azizelse-0v2/complexio/Assets/QFN_24.STEP

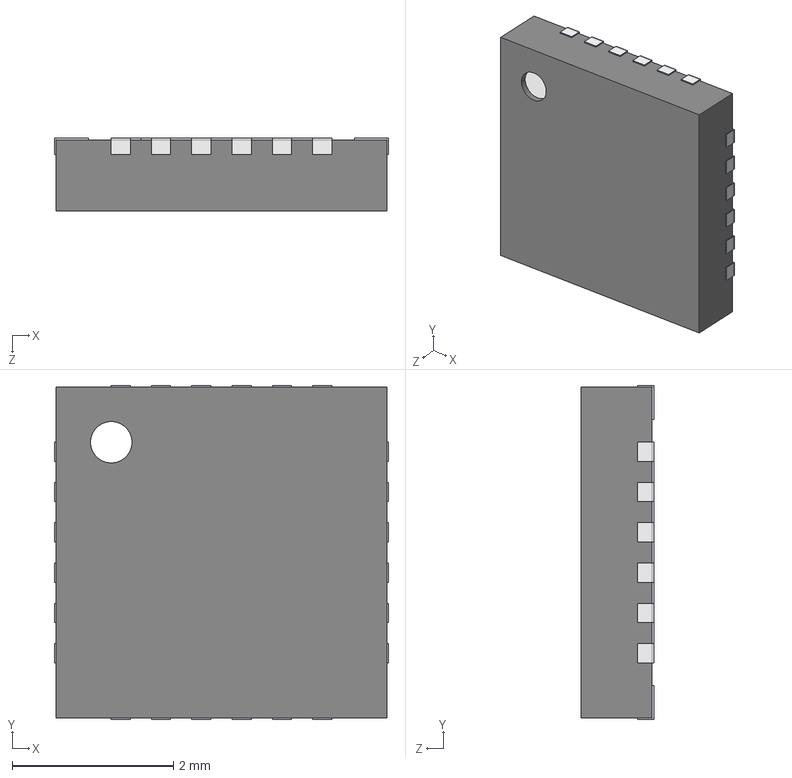
[picture p1: CAD file, 2026-03-24]
Assets/QFN_24.STEP
4.14 x 4.14 x 0.9 mm
Open_CASCADE_STEP_translator_6.8_11.2.1.step_Varsay考an
Open_CASCADE_STEP_translator_6.8_11.4.1.step_Varsay考an x 24
Open_CASCADE_STEP_translator_6.8_11.1.step_Varsay考an
Thermal_Shape.step_Varsay考an
