azizelse-0v2/complexio/Assets/hc-05.stl

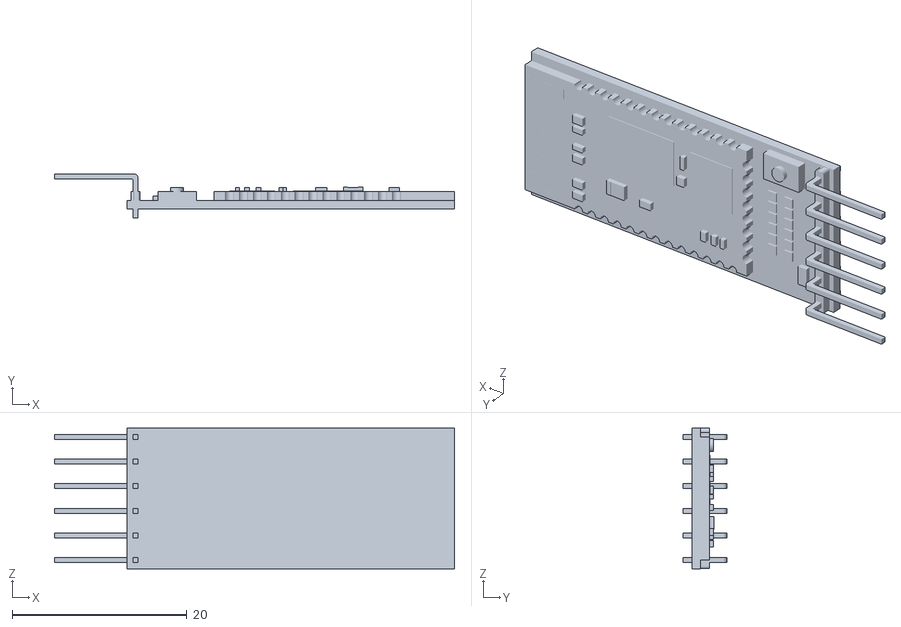
[picture p2: CAD file, 2026-03-23]
Assets/hc-05.stl
45.8 x 5.00 x 16.1
