azizelse-0v2/complexio/Assets/AT24C01C-SSHM-B.STEP

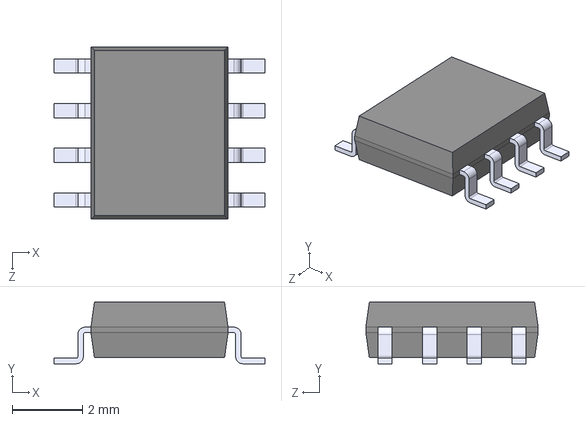
[picture p3: CAD file, 2026-03-23]
Assets/AT24C01C-SSHM-B.STEP
6.00 x 1.75 x 4.90 mm
