azizelse-0v2/complexio/Assets/SN74LVC16T245DGGR.STEP

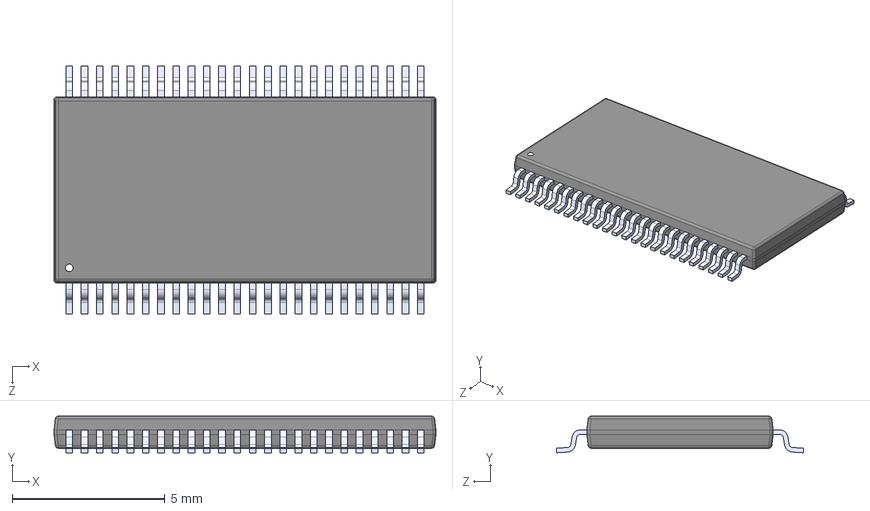
[picture p4: CAD file, 2026-03-23]
Assets/SN74LVC16T245DGGR.STEP
12.5 x 1.20 x 8.10 mm
