azizelse-0v2/complexio/Assets/oled_spi.stp

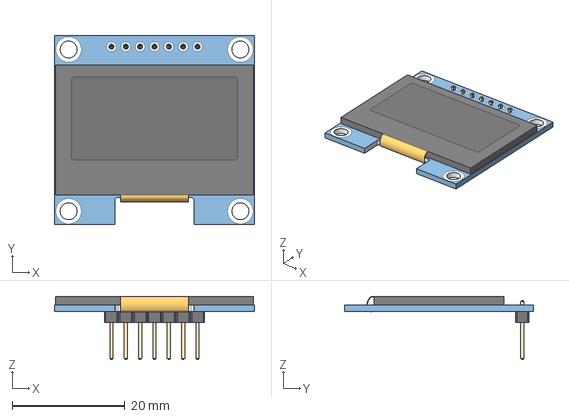
[picture p5: CAD file, 2026-03-23]
Assets/oled_spi.stp
35.4 x 33.5 x 11.2 mm
