azizelse-0v2/complexio/Assets/ktir0711s-1.stp

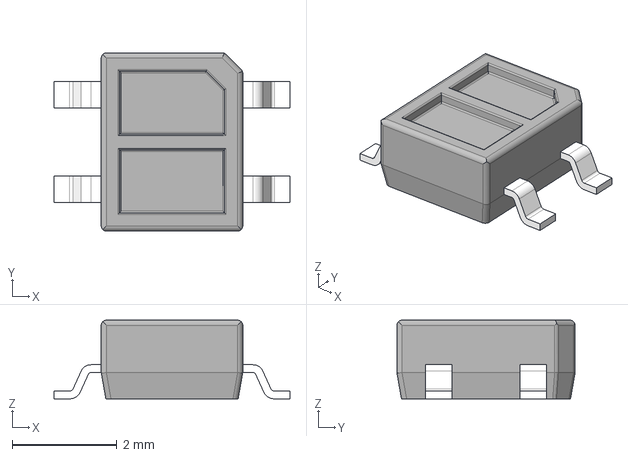
[picture p6: CAD file, 2026-03-22]
Assets/ktir0711s-1.stp
4.50 x 3.40 x 1.50 mm
