azizelse-0v2/complexio/PCB/complexio/complexio.kicad_pcb

## KiCad design PCB/complexio/complexio.kicad_pcb (2026-03-25)

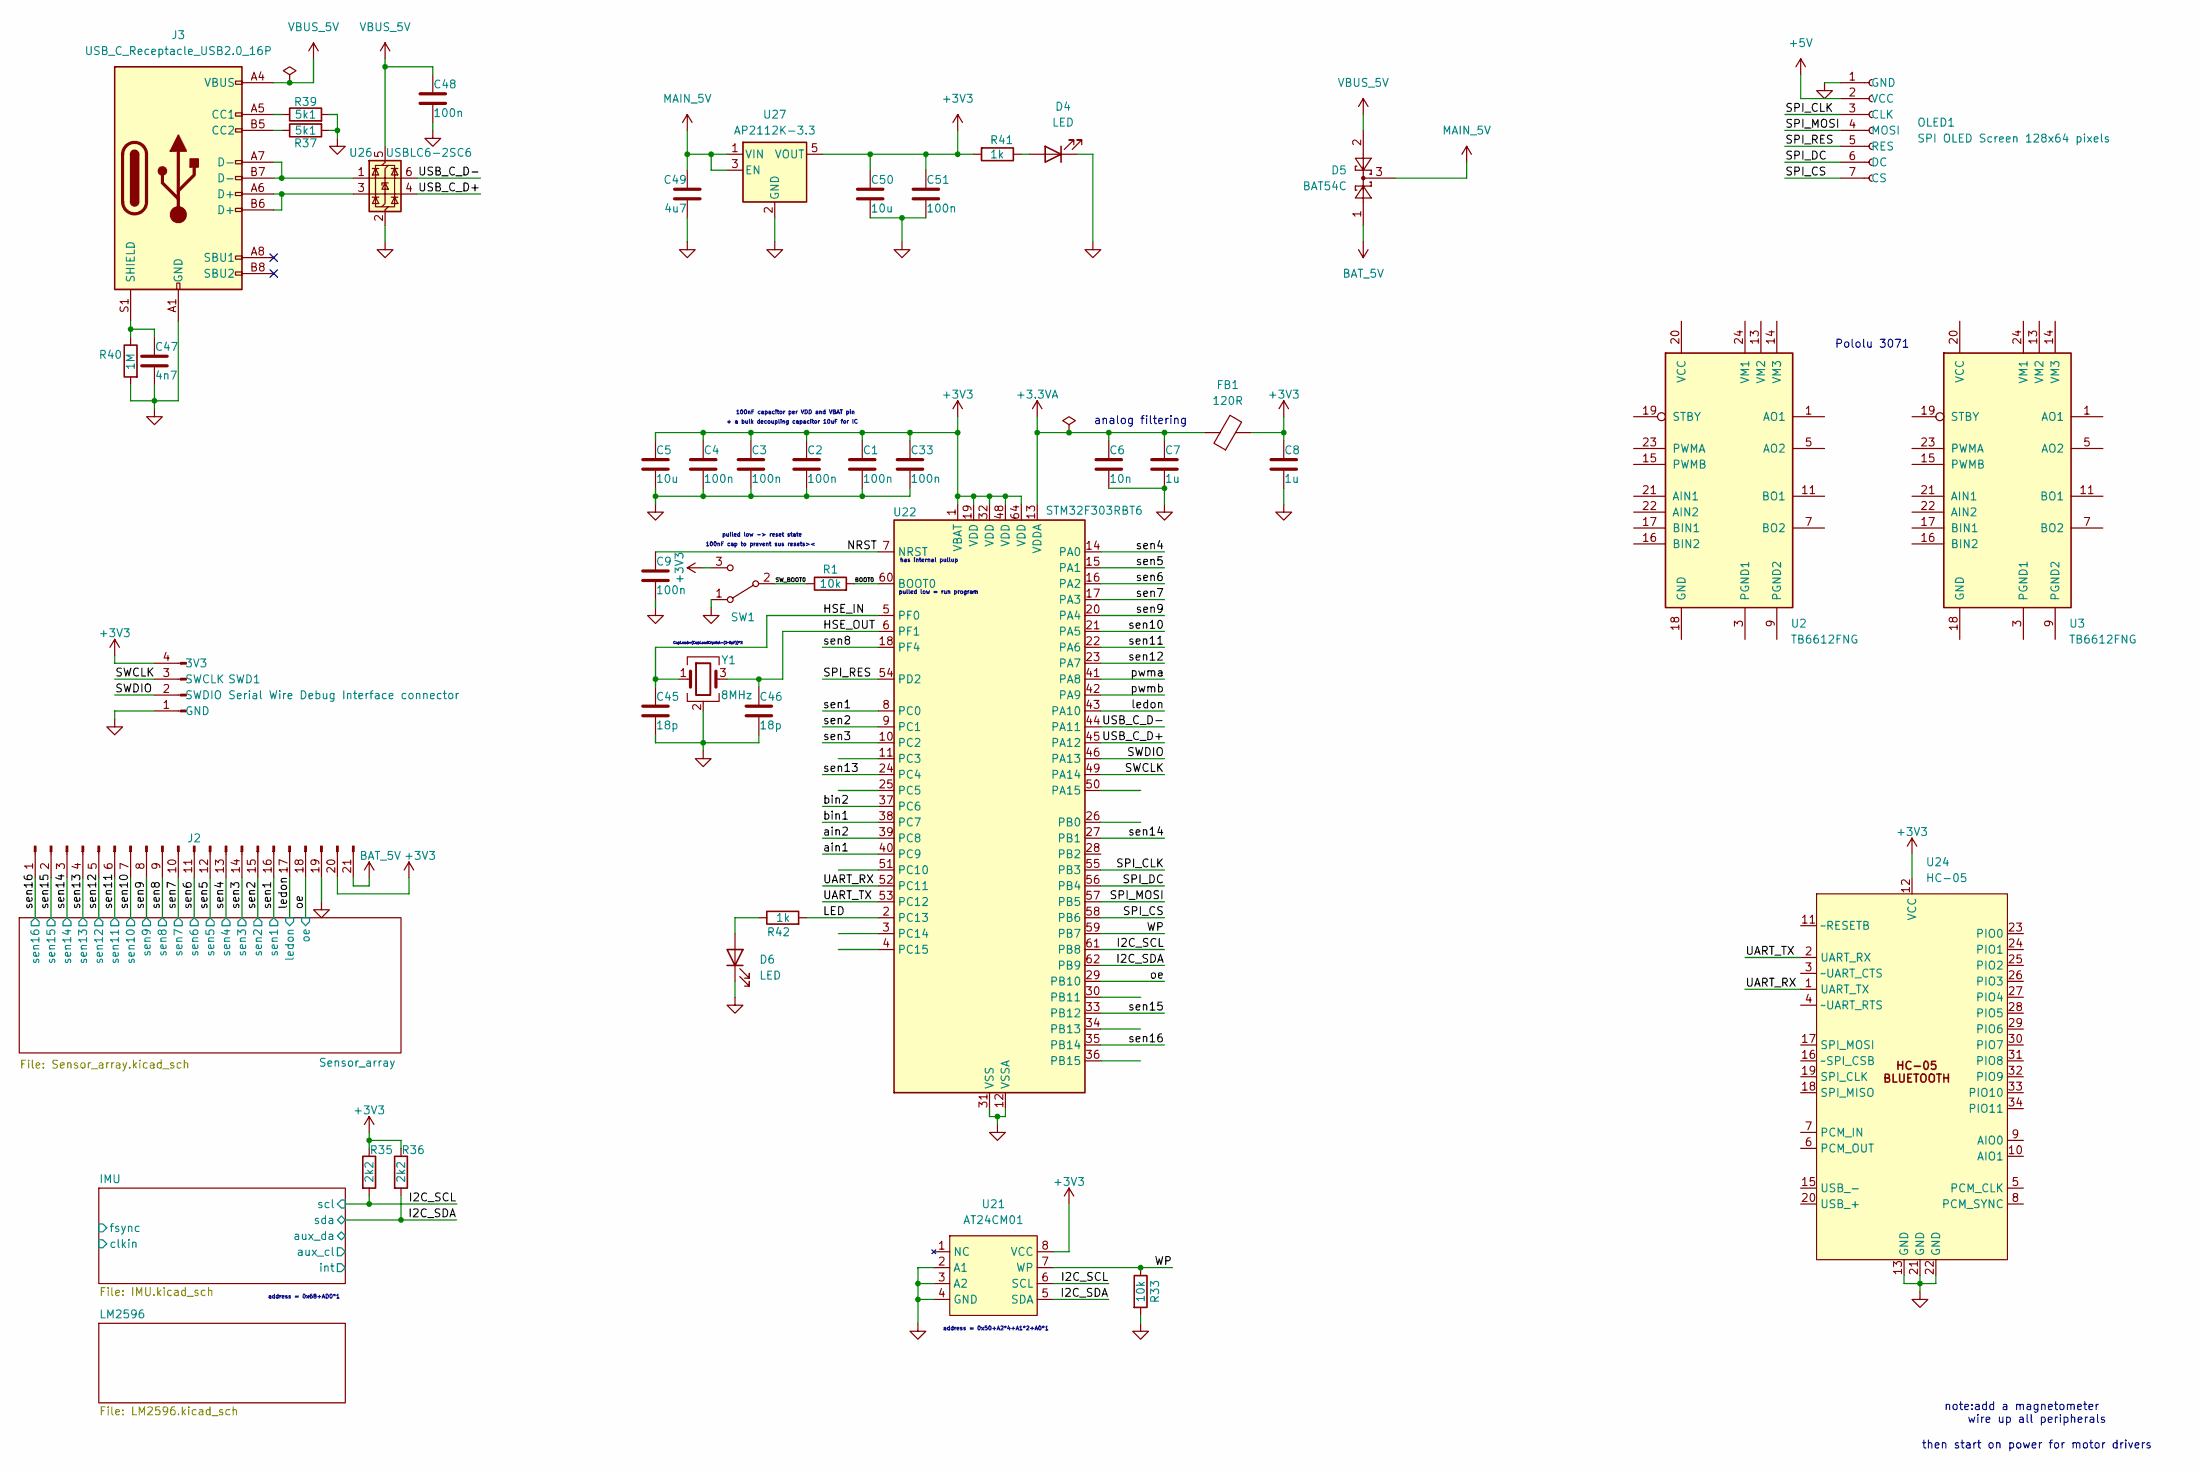
[picture p7: schematic complexio.kicad_sch, Complex Line Follower Robot]

Parts:
C1, C2, C3, C4, C9, C33, C48, C51: 100n; C_0402_1005Metric; MFR.Part # CL05B104KO5NNNC; JLCPCB Part # C1525
C5, C50: 10u; C_0603_1608Metric; MFR.Part # CL10A106MQ8NNNC; JLCPCB Part # C1691
C6: 10n; C_0402_1005Metric; MFR.Part # CL05B103KB5NNNC; JLCPCB Part # C15195
C7, C8: 1u; C_0402_1005Metric; MFR.Part # CL05A105KP5NNNC; JLCPCB Part # C14445
C45, C46: 18p; C_0402_1005Metric; MFR.Part # 0402CG180J500NT; JLCPCB Part # C1549
C47: 4n7; C_1206_3216Metric; MFR.Part # 1206B472K501NT; JLCPCB Part # C30323
C49: 4u7; C_0603_1608Metric; MFR.Part # CL10A475KP8NNNC; JLCPCB Part # C1705
D4, D6: LED; LED_0201_0603Metric; MFR.Part # KT-0603R; JLCPCB Part # C2286
D5: BAT54C; SOT-23; MFR.Part # MBR2060CT-LJ; JLCPCB Part # C82585
FB1: 120R; L_0603_1608Metric; MFR.Part # VHF160808H1N8ST; JLCPCB Part # C1026
J2: Conn_01x21_Pin; PinHeader_1x21_P1.27mm_Horizontal; MFR.Part # PZ1.27-1*50; JLCPCB Part # C5360892
J3: USB_C_Receptacle_USB2.0_16P; USB_C_Receptacle_GCT_USB4105-xx-A_16P_TopMnt_Horizontal
OLED1: SPI OLED Screen 128x64 pixels; SSD1306_SPI; MFR.Part # KH-2.54FH-1X7P-H8.5; JLCPCB Part # C2932672
R1, R33: 10k; R_0402_1005Metric; MFR.Part # RCT0210KJLF; JLCPCB Part # C174175
R35, R36: 2k2; R_0603_1608Metric; MFR.Part # 0603WAF2201T5E; JLCPCB Part # C4190
R37, R39: 5k1; R_0603_1608Metric; MFR.Part # 0603WAF5101T5E; JLCPCB Part # C23186
R40: 1M; R_1206_3216Metric; MFR.Part # HR1206J1M00P05Z; JLCPCB Part # C175518
R41, R42: 1k; R_1206_3216Metric; MFR.Part # 1206W4J0102T5E; JLCPCB Part # C1469
SW1: SW_SPDT; SW_E-Switch_EG1224_SPDT_Angled; MFR.Part # EG1224; JLCPCB Part # C273395
SWD1: Serial Wire Debug Interface connector; PinHeader_1x04_P2.54mm_Horizontal; MFR.Part # 2.54-1*4P反弯排针; JLCPCB Part # C91552
U2, U3: TB6612FNG; SSOP-24_5.3x8.2mm_P0.65mm; MFR.Part # TB6612FNG,C,8,EL; JLCPCB Part # C141517
U21: AT24CM01; MFR.Part # AT24CM01-SHD-T; JLCPCB Part # C36057
U22: STM32F303RBT6; LQFP-64_10x10mm_P0.5mm; MFR.Part # STM32F303RBT6; JLCPCB Part # C130453
U24: HC-05; HC-05_SMD
U26: USBLC6-2SC6; SOT-23-6
U27: AP2112K-3.3; SOT-23-5
Y1: 8MHz; Crystal_SMD_3225-4Pin_3.2x2.5mm; MFR.Part # XXDCELNANF-8MHZ

Connections:
+3.3VA: C6.1, C7.1, FB1.1, U22.13 (VDDA)
+3V3: C1.1, C2.1, C3.1, C4.1, C5.1, C8.1, C33.1, C50.1, C51.1, FB1.2, J2.20, R35.1, R36.1, R41.2, SW1.3 (C), SWD1.4 (3V3), U21.8 (VCC), U22.1 (VBAT), U22.19 (VDD), U22.32 (VDD), U22.48 (VDD), U22.64 (VDD), U24.12 (VCC), U27.5 (VOUT); also elsewhere on the board
+5V: OLED1.2 (VCC)
/BOOT0: R1.2, U22.60 (BOOT0)
/HSE_IN: C45.1, U22.5 (PF0), Y1.1
/HSE_OUT: C46.1, U22.6 (PF1), Y1.3
/I2C_SCL: R35.2, U21.6 (SCL), U22.61 (PB8); also elsewhere on the board
/I2C_SDA: R36.2, U21.5 (SDA), U22.62 (PB9); also elsewhere on the board
/LED: R42.2, U22.2 (PC13)
/NRST: C9.1, U22.7 (NRST)
/SPI_CLK: OLED1.3 (CLK), U22.55 (PB3)
/SPI_CS: OLED1.7 (CS), U22.58 (PB6)
/SPI_DC: OLED1.6 (DC), U22.56 (PB4)
/SPI_MOSI: OLED1.4 (MOSI), U22.57 (PB5)
/SPI_RES: OLED1.5 (RES), U22.54 (PD2)
/SWCLK: SWD1.3 (SWCLK), U22.49 (PA14)
/SWDIO: SWD1.2 (SWDIO), U22.46 (PA13)
/SW_BOOT0: R1.1, SW1.2 (B)
/UART_RX: U22.52 (PC11), U24.1 (UART_TX)
/UART_TX: U22.53 (PC12), U24.2 (UART_RX)
/USB_C_D+: U22.45 (PA12), U26.4 (I/O2)
/USB_C_D-: U22.44 (PA11), U26.6 (I/O1)
/WP: R33.1, U21.7 (WP), U22.59 (PB7)
/ain1: U22.40 (PC9)
/ain2: U22.39 (PC8)
/bin1: U22.38 (PC7)
/bin2: U22.37 (PC6)
/ledon: J2.17, U22.43 (PA10); also elsewhere on the board
/oe: J2.18, U22.29 (PB10); also elsewhere on the board
/pwma: U22.41 (PA8)
/pwmb: U22.42 (PA9)
/sen1: J2.16, U22.8 (PC0); also elsewhere on the board
/sen2: J2.15, U22.9 (PC1); also elsewhere on the board
/sen3: J2.14, U22.10 (PC2); also elsewhere on the board
/sen4: J2.13, U22.14 (PA0); also elsewhere on the board
/sen5: J2.12, U22.15 (PA1); also elsewhere on the board
/sen6: J2.11, U22.16 (PA2); also elsewhere on the board
/sen7: J2.10, U22.17 (PA3); also elsewhere on the board
/sen8: J2.9, U22.18 (PF4); also elsewhere on the board
/sen9: J2.8, U22.20 (PA4); also elsewhere on the board
/sen10: J2.7, U22.21 (PA5); also elsewhere on the board
/sen11: J2.6, U22.22 (PA6); also elsewhere on the board
/sen12: J2.5, U22.23 (PA7); also elsewhere on the board
/sen13: J2.4, U22.24 (PC4); also elsewhere on the board
/sen14: J2.3, U22.27 (PB1); also elsewhere on the board
/sen15: J2.2, U22.33 (PB12); also elsewhere on the board
/sen16: J2.1, U22.35 (PB14); also elsewhere on the board
BAT_5V: D5.1, J2.21; also elsewhere on the board
GND: C1.2, C2.2, C3.2, C4.2, C5.2, C6.2, C7.2, C8.2, C9.2, C33.2, C45.2, C46.2, C47.2, C48.2, C49.2, C50.2, C51.2, D4.1 (K), D6.1 (K), J2.19, J3.A1 (GND), J3.A12 (GND), J3.B1 (GND), J3.B12 (GND), OLED1.1 (GND), R33.2, R37.2, R39.2, R40.2, SW1.1 (A), SWD1.1 (GND), U21.2 (A1), U21.3 (A2), U21.4 (GND), U22.12 (VSSA), U22.31 (VSS), U22.47 (VSS), U22.63 (VSS), U24.13 (GND), U24.21 (GND), U24.22 (GND), U26.2 (GND), U27.2 (GND), Y1.2 (G), Y1.4 (G); also elsewhere on the board
MAIN_5V: C49.1, D5.3, U27.1 (VIN), U27.3 (EN); also elsewhere on the board
unnamed: D4.2 (A), R41.1
unnamed: D6.2 (A), R42.1
unnamed: J3.A5 (CC1), R39.1
unnamed: J3.B5 (CC2), R37.1
unnamed: J3.A6 (D+), J3.B6 (D+), U26.3 (I/O2)
unnamed: J3.A7 (D-), J3.B7 (D-), U26.1 (I/O1)
unnamed: C47.1, J3.S1 (SHIELD), R40.1
unnamed: U2.1 (AO1), U2.2 (AO1)
unnamed: U2.5 (AO2), U2.6 (AO2)
unnamed: U2.11 (BO1), U2.12 (BO1)
unnamed: U2.7 (BO2), U2.8 (BO2)
unnamed: U2.3 (PGND1), U2.4 (PGND1)
unnamed: U2.9 (PGND2), U2.10 (PGND2)
unnamed: U3.1 (AO1), U3.2 (AO1)
unnamed: U3.5 (AO2), U3.6 (AO2)
unnamed: U3.11 (BO1), U3.12 (BO1)
unnamed: U3.7 (BO2), U3.8 (BO2)
unnamed: U3.3 (PGND1), U3.4 (PGND1)
unnamed: U3.9 (PGND2), U3.10 (PGND2)
VBUS_5V: C48.1, D5.2, J3.A4 (VBUS), J3.A9 (VBUS), J3.B4 (VBUS), J3.B9 (VBUS), U26.5 (VBUS)

Notes on the sheet:
+ a bulk decoupling capacitor 10uF for IC
pulled low -> reset state
100nF capacitor per VDD and VBAT pin
has internal pullup
note:add a magnetometer wire up all peripherals then start on power for motor drivers
address = 0x68+AD0*1
analog filtering
100nF cap to prevent sus resets><
pulled low = run program
Pololu 3071
address = 0x50+A2*4+A1*2+A0*1
CapLoad=(CapLoadCrystal-(3~5pF))*2

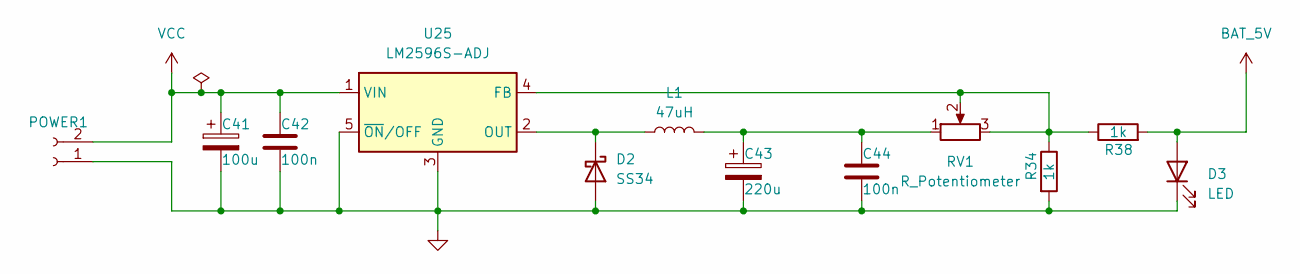
[picture p8: schematic LM2596.kicad_sch, LM2596 Buck converter]

Parts:
C41: 100u; CP_Elec_8x10
C42, C44: 100n; C_0402_1005Metric; MFR.Part # CL05B104KO5NNNC; JLCPCB Part # C1525
C43: 220u; CP_Elec_8x10
D2: SS34; D_SMA; MFR.Part # B340LA-13-F; JLCPCB Part # C17101
D3: LED; LED_0201_0603Metric; MFR.Part # KT-0603R; JLCPCB Part # C2286
L1: 47uH; L_Bourns_SRR1208_12.7x12.7mm
POWER1: Conn_01x02_Socket; AMASS_XT60-M_1x02_P7.20mm_Vertical; MFR.Part # XT60-M.; JLCPCB Part # C98733
R34, R38: 1k; R_1206_3216Metric; MFR.Part # 1206W4J0102T5E; JLCPCB Part # C1469
RV1: R_Potentiometer; Potentiometer_Bourns_3296W_Vertical
U25: LM2596S-ADJ; TO-263-5_TabPin3; MFR.Part # LM2596R-ADJ; JLCPCB Part # C52684

Connections:
BAT_5V: D3.2 (A), R38.2; also elsewhere on the board
GND: C41.2, C42.2, C43.2, C44.2, D2.2 (A), D3.1 (K), POWER1.1, R34.2, U25.3 (GND), U25.5 (~ON/OFF); also elsewhere on the board
unnamed: C43.1, C44.1, L1.2, RV1.1
unnamed: D2.1 (K), L1.1, U25.2 (OUT)
unnamed: R34.1, R38.1, RV1.2, RV1.3, U25.4 (FB)
VCC: C41.1, C42.1, POWER1.2, U25.1 (VIN)

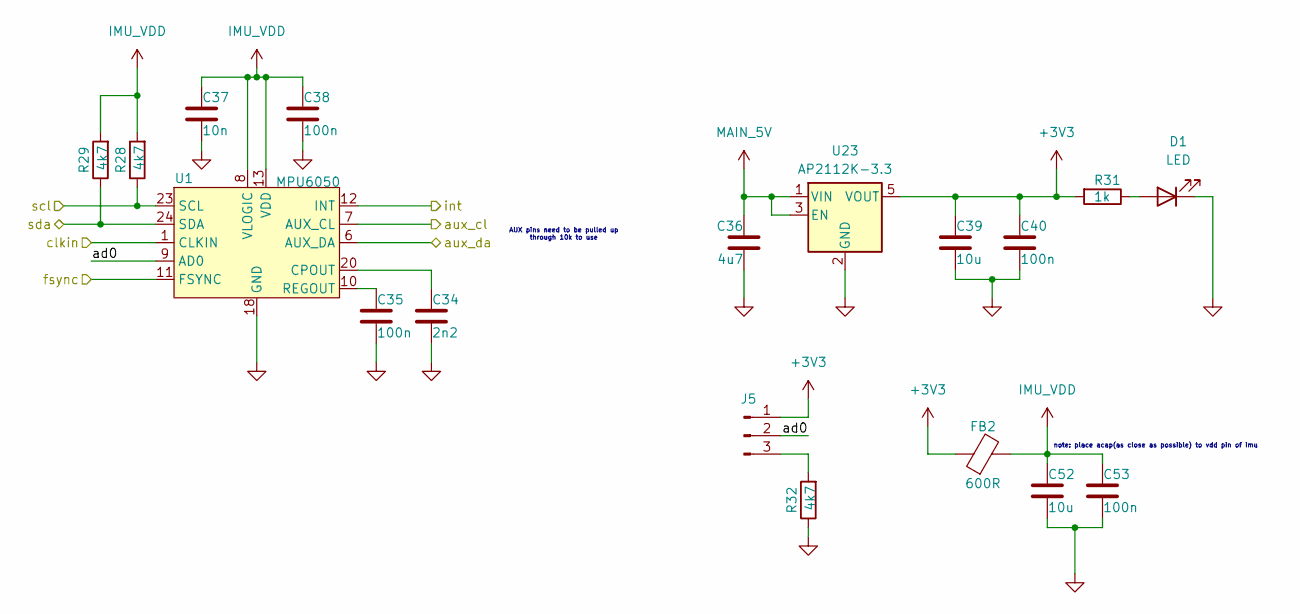
[picture p9: schematic IMU.kicad_sch, IMU schem based on MPU6050]

Parts:
C34: 2n2; C_0402_1005Metric; MFR.Part # CC0402KRX7R9BB222; JLCPCB Part # C106861
C35, C38, C40, C53: 100n; C_0402_1005Metric; MFR.Part # CL05B104KO5NNNC; JLCPCB Part # C1525
C36: 4u7; C_0603_1608Metric; MFR.Part # CL10A475KP8NNNC; JLCPCB Part # C1705
C37: 10n; C_0402_1005Metric; MFR.Part # CL05B103KB5NNNC; JLCPCB Part # C15195
C39, C52: 10u; C_0603_1608Metric; MFR.Part # CL10A106MQ8NNNC; JLCPCB Part # C1691
D1: LED; LED_0201_0603Metric; MFR.Part # KT-0603R; JLCPCB Part # C2286
FB2: 600R; L_0603_1608Metric; MFR.Part # BLM18AG601SN1D; JLCPCB Part # C19330
J5: Conn_01x03_Pin; PinSocket_1x03_P2.54mm_Vertical; MFR.Part # 2.54-1*3PPin; JLCPCB Part # C49257
R28, R29, R32: 4k7; R_0402_1005Metric; MFR.Part # 0402WGF4701TCE; JLCPCB Part # C25900
R31: 1k; R_1206_3216Metric; MFR.Part # 1206W4J0102T5E; JLCPCB Part # C1469
U1: MPU6050; MPU6050SMD
U23: AP2112K-3.3; SOT-23-5

Connections:
+3V3: C39.1, C40.1, FB2.1, J5.1, R31.2, U23.5 (VOUT); also elsewhere on the board
/I2C_SCL: R28.1, U1.23 (SCL); also elsewhere on the board
/I2C_SDA: R29.1, U1.24 (SDA); also elsewhere on the board
/IMU/ad0: J5.2, U1.9 (AD0)
/IMU/aux_cl: U1.7 (AUX_CL)
/IMU/aux_da: U1.6 (AUX_DA)
/IMU/clkin: U1.1 (CLKIN)
/IMU/fsync: U1.11 (FSYNC)
/IMU/int: U1.12 (INT)
GND: C34.2, C35.2, C36.2, C37.2, C38.2, C39.2, C40.2, C52.2, C53.2, D1.1 (K), R32.1, U1.18 (GND), U23.2 (GND); also elsewhere on the board
IMU_VDD: C37.1, C38.1, C52.1, C53.1, FB2.2, R28.2, R29.2, U1.8 (VLOGIC), U1.13 (VDD)
MAIN_5V: C36.1, U23.1 (VIN), U23.3 (EN); also elsewhere on the board
unnamed: D1.2 (A), R31.1
unnamed: J5.3, R32.2
unnamed: C34.1, U1.20 (CPOUT)
unnamed: C35.1, U1.10 (REGOUT)

Notes on the sheet:
AUX pins need to be pulled up through 10k to use
note: place acap(as close as possible) to vdd pin of imu

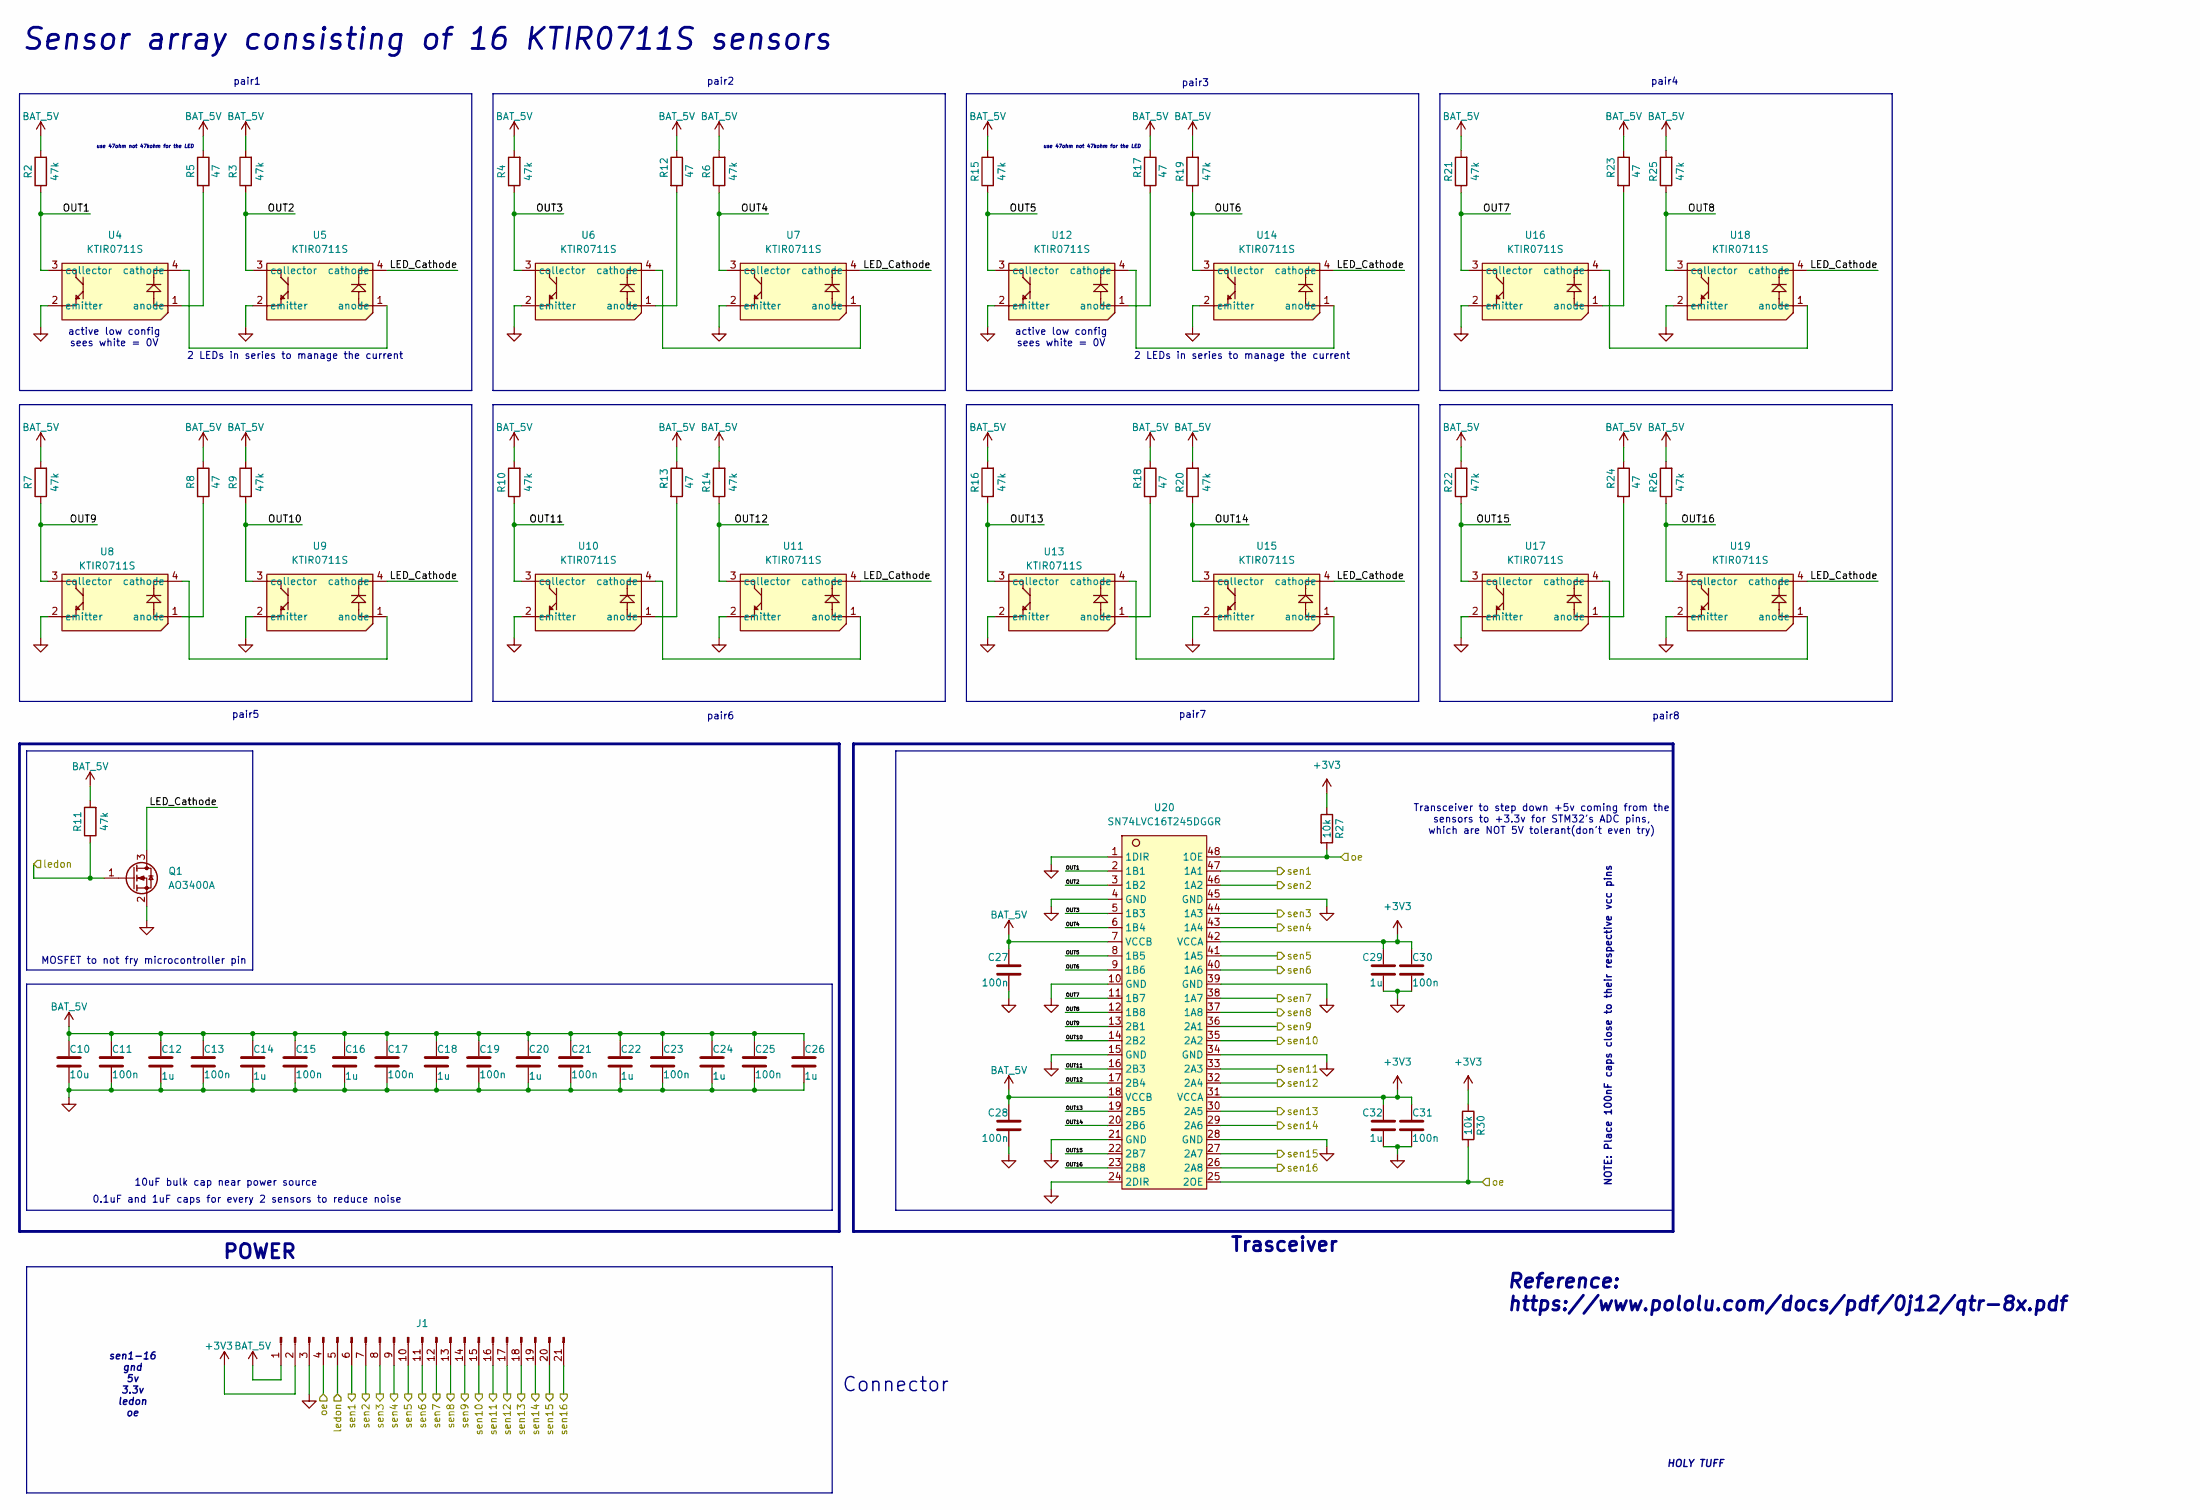
[picture p10: schematic Sensor_array.kicad_sch, Sensor array]

Parts:
C10: 10u; C_0603_1608Metric; MFR.Part # CL10A106MQ8NNNC; JLCPCB Part # C1691
C11, C13, C15, C17, C19, C21, C23, C25, C27, C28, C30, C31: 100n; C_0402_1005Metric; MFR.Part # CL05B104KO5NNNC; JLCPCB Part # C1525
C12, C14, C16, C18, C20, C22, C24, C26, C29, C32: 1u; C_0402_1005Metric; MFR.Part # CL05A105KP5NNNC; JLCPCB Part # C14445
J1: Conn_01x21_Pin; PinHeader_1x21_P1.27mm_Horizontal; MFR.Part # PZ1.27-1*50; JLCPCB Part # C5360892
Q1: AO3400A; SOT-23
R2, R3, R4, R6, R7, R9, R10, R11, R14, R15, R16, R19, R20, R21, R22, R25, R26: 47k; R_0402_1005Metric; MFR.Part # RCA0247KJLF; JLCPCB Part # C22356233
R5, R8, R12, R13, R17, R18, R23, R24: 47; R_1206_3216Metric; MFR.Part # RCT0647RJLF; JLCPCB Part # C702856
R27, R30: 10k; R_0402_1005Metric; MFR.Part # RCT0210KJLF; JLCPCB Part # C174175
U4, U5, U6, U7, U8, U9, U10, U11, U12, U13, U14, U15, U16, U17, U18, U19: KTIR0711S; MFR.Part # KTIR0711S; JLCPCB Part # C3034700
U20: SN74LVC16T245DGGR

Connections:
+3V3: C29.1, C30.1, C31.1, C32.1, J1.2, R27.1, R30.1, U20.31 (VCCA), U20.42 (VCCA); also elsewhere on the board
/Sensor_array/LED_Cathode: Q1.3 (D), U5.4 (cathode), U7.4 (cathode), U9.4 (cathode), U11.4 (cathode), U14.4 (cathode), U15.4 (cathode), U18.4 (cathode), U19.4 (cathode)
/Sensor_array/OUT1: R2.1, U4.3 (collector), U20.2 (1B1)
/Sensor_array/OUT2: R3.1, U5.3 (collector), U20.3 (1B2)
/Sensor_array/OUT3: R4.1, U6.3 (collector), U20.5 (1B3)
/Sensor_array/OUT4: R6.1, U7.3 (collector), U20.6 (1B4)
/Sensor_array/OUT5: R15.1, U12.3 (collector), U20.8 (1B5)
/Sensor_array/OUT6: R19.1, U14.3 (collector), U20.9 (1B6)
/Sensor_array/OUT7: R21.1, U16.3 (collector), U20.11 (1B7)
/Sensor_array/OUT8: R25.1, U18.3 (collector), U20.12 (1B8)
/Sensor_array/OUT9: R7.1, U8.3 (collector), U20.13 (2B1)
/Sensor_array/OUT10: R9.1, U9.3 (collector), U20.14 (2B2)
/Sensor_array/OUT11: R10.1, U10.3 (collector), U20.16 (2B3)
/Sensor_array/OUT12: R14.1, U11.3 (collector), U20.17 (2B4)
/Sensor_array/OUT13: R16.1, U13.3 (collector), U20.19 (2B5)
/Sensor_array/OUT14: R20.1, U15.3 (collector), U20.20 (2B6)
/Sensor_array/OUT15: R22.1, U17.3 (collector), U20.22 (2B7)
/Sensor_array/OUT16: R26.1, U19.3 (collector), U20.23 (2B8)
/ledon: J1.5, Q1.1 (G), R11.1; also elsewhere on the board
/oe: J1.4, R27.2, R30.2, U20.25 (2OE), U20.48 (1OE); also elsewhere on the board
/sen1: J1.6, U20.47 (1A1); also elsewhere on the board
/sen2: J1.7, U20.46 (1A2); also elsewhere on the board
/sen3: J1.8, U20.44 (1A3); also elsewhere on the board
/sen4: J1.9, U20.43 (1A4); also elsewhere on the board
/sen5: J1.10, U20.41 (1A5); also elsewhere on the board
/sen6: J1.11, U20.40 (1A6); also elsewhere on the board
/sen7: J1.12, U20.38 (1A7); also elsewhere on the board
/sen8: J1.13, U20.37 (1A8); also elsewhere on the board
/sen9: J1.14, U20.36 (2A1); also elsewhere on the board
/sen10: J1.15, U20.35 (2A2); also elsewhere on the board
/sen11: J1.16, U20.33 (2A3); also elsewhere on the board
/sen12: J1.17, U20.32 (2A4); also elsewhere on the board
/sen13: J1.18, U20.30 (2A5); also elsewhere on the board
/sen14: J1.19, U20.29 (2A6); also elsewhere on the board
/sen15: J1.20, U20.27 (2A7); also elsewhere on the board
/sen16: J1.21, U20.26 (2A8); also elsewhere on the board
BAT_5V: C10.1, C11.1, C12.1, C13.1, C14.1, C15.1, C16.1, C17.1, C18.1, C19.1, C20.1, C21.1, C22.1, C23.1, C24.1, C25.1, C26.1, C27.1, C28.1, J1.1, R2.2, R3.2, R4.2, R5.1, R6.2, R7.2, R8.1, R9.2, R10.2, R11.2, R12.1, R13.1, R14.2, R15.2, R16.2, R17.1, R18.1, R19.2, R20.2, R21.2, R22.2, R23.1, R24.1, R25.2, R26.2, U20.7 (VCCB), U20.18 (VCCB); also elsewhere on the board
GND: C10.2, C11.2, C12.2, C13.2, C14.2, C15.2, C16.2, C17.2, C18.2, C19.2, C20.2, C21.2, C22.2, C23.2, C24.2, C25.2, C26.2, C27.2, C28.2, C29.2, C30.2, C31.2, C32.2, J1.3, Q1.2 (S), U4.2 (emitter), U5.2 (emitter), U6.2 (emitter), U7.2 (emitter), U8.2 (emitter), U9.2 (emitter), U10.2 (emitter), U11.2 (emitter), U12.2 (emitter), U13.2 (emitter), U14.2 (emitter), U15.2 (emitter), U16.2 (emitter), U17.2 (emitter), U18.2 (emitter), U19.2 (emitter), U20.1 (1DIR), U20.4 (GND), U20.10 (GND), U20.15 (GND), U20.21 (GND), U20.24 (2DIR), U20.28 (GND), U20.34 (GND), U20.39 (GND), U20.45 (GND); also elsewhere on the board
unnamed: R5.2, U4.1 (anode)
unnamed: U4.4 (cathode), U5.1 (anode)
unnamed: R12.2, U6.1 (anode)
unnamed: U6.4 (cathode), U7.1 (anode)
unnamed: R8.2, U8.1 (anode)
unnamed: U8.4 (cathode), U9.1 (anode)
unnamed: R13.2, U10.1 (anode)
unnamed: U10.4 (cathode), U11.1 (anode)
unnamed: R17.2, U12.1 (anode)
unnamed: U12.4 (cathode), U14.1 (anode)
unnamed: R18.2, U13.1 (anode)
unnamed: U13.4 (cathode), U15.1 (anode)
unnamed: R23.2, U16.1 (anode)
unnamed: U16.4 (cathode), U18.1 (anode)
unnamed: R24.2, U17.1 (anode)
unnamed: U17.4 (cathode), U19.1 (anode)

Notes on the sheet:
2 LEDs in series to manage the current
Reference: https://www.pololu.com/docs/pdf/0j12/qtr-8x.pdf
pair8
sen1-16 gnd 5v 3.3v ledon oe
0.1uF and 1uF caps for every 2 sensors to reduce noise
Trasceiver
pair2
pair5
pair3
NOTE: Place 100nF caps close to their respective vcc pins
Sensor array consisting of 16 KTIR0711S sensors
HOLY TUFF
pair4
pair1
MOSFET to not fry microcontroller pin
pair7
POWER
Connector
pair6
active low config sees white = 0V
10uF bulk cap near power source
use 47ohm not 47kohm for the LED
Transceiver to step down +5v coming from the sensors to +3.3v for STM32's ADC pins, which are NOT 5V tolerant(don't even try)

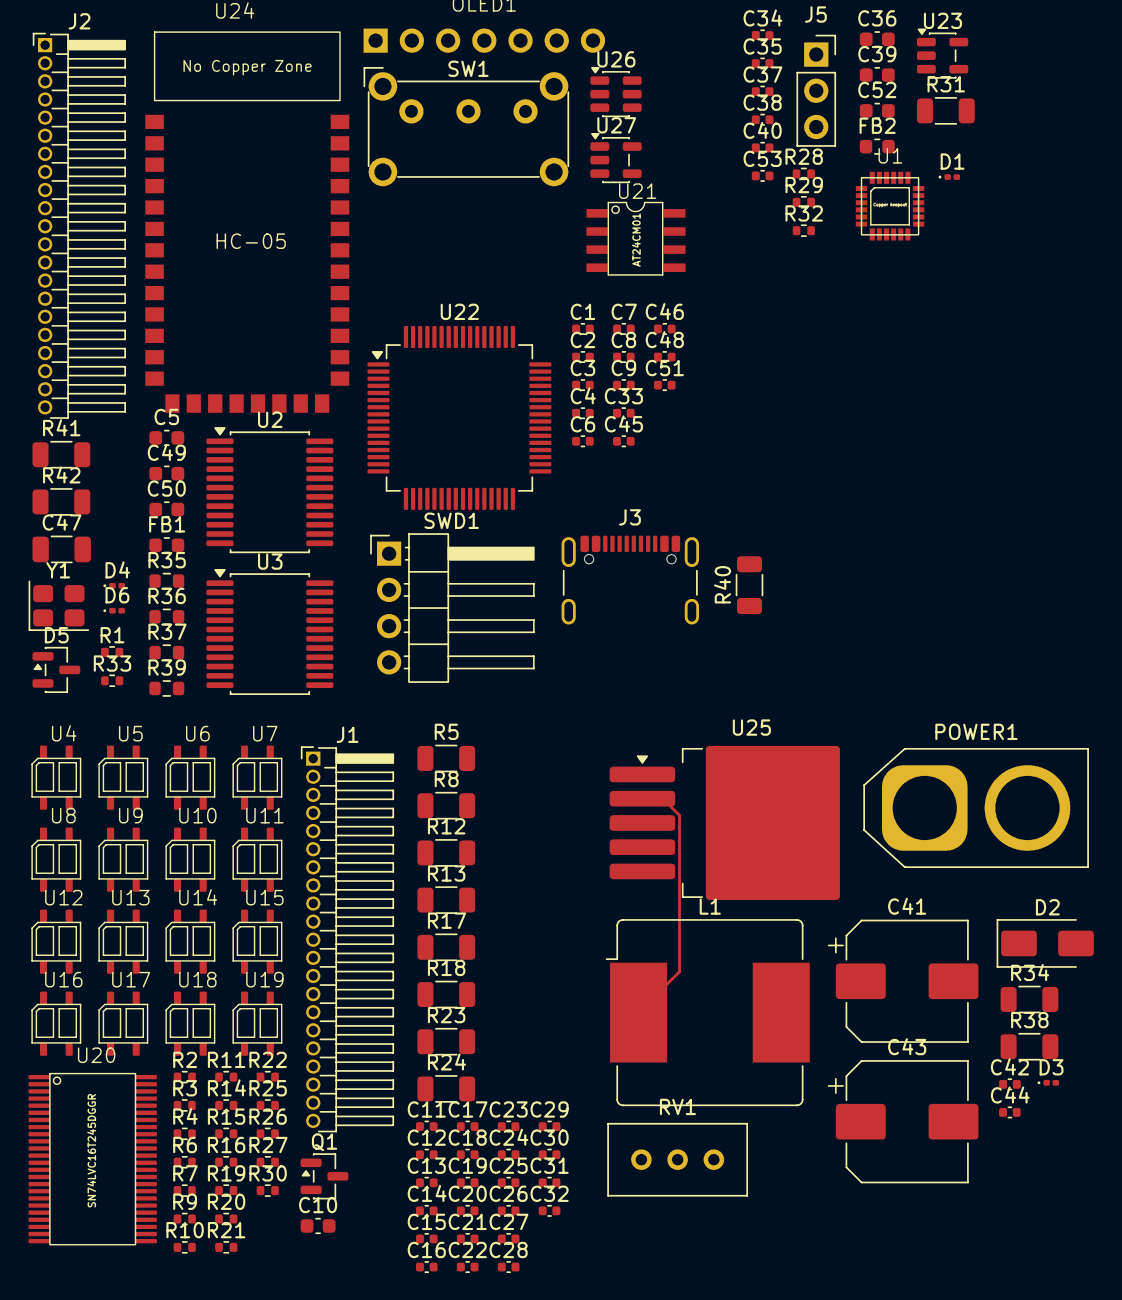
[picture p11: board complexio.kicad_pcb from above]

Board: 2 copper layers, 142 parts (0 on the bottom side), 106 nets.
