azizelse-0v2/complexio/Firmware/Complexio/Complexio.ioc

Mcu.UserName=STM32F303RBTx
PA0.GPIO_Label=sen4
PA0.Signal=ADC1_IN1
PA1.GPIO_Label=sen5
PA1.Signal=ADC1_IN2
PA11.Signal=USB_DM
PA12.Signal=USB_DP
PA13.Signal=SYS_JTMS-SWDIO
PA14.Signal=SYS_JTCK-SWCLK
PA2.GPIO_Label=sen6
PA2.Signal=ADC1_IN3
PA3.GPIO_Label=sen7
PA3.Signal=ADC1_IN4
PA4.GPIO_Label=sen9
PA4.Signal=ADC2_IN1
PA5.GPIO_Label=sen10
PA5.Signal=ADC2_IN2
PA6.GPIO_Label=sen11
PA6.Signal=ADC2_IN3
PA7.GPIO_Label=sen12
PA7.Signal=ADC2_IN4
PA8.GPIO_Label=pwma
PA8.Signal=S_TIM1_CH1
PA9.GPIO_Label=pwmb
PA9.Signal=S_TIM1_CH2
PB1.GPIO_Label=sen14
PB1.Signal=ADC3_IN1
PB12.GPIO_Label=sen15
PB12.Signal=ADC4_IN3
PB14.GPIO_Label=sen16
PB14.Signal=ADC4_IN4
PB3.Signal=SPI1_SCK
PB4.GPIO_Label=DC
PB4.Signal=GPIO_Output
PB5.Signal=SPI1_MOSI
PB6.GPIO_Label=CS
PB6.Signal=GPIO_Output
PB8.Signal=I2C1_SCL
PB9.Signal=I2C1_SDA
PC0.GPIO_Label=sen1
PC0.Signal=ADCx_IN6
PC1.GPIO_Label=sen2
PC1.Signal=ADCx_IN7
PC10.GPIO_Label=tx
PC10.Signal=UART4_TX
PC11.GPIO_Label=rx
PC11.Signal=UART4_RX
PC13.GPIO_Label=LED
PC13.Signal=GPIO_Output
PC2.GPIO_Label=sen3
PC2.Signal=ADCx_IN8
PC4.GPIO_Label=sen13
PC4.Signal=ADC2_IN5
PC6.GPIO_Label=bin2
PC6.Signal=GPIO_Output
PC7.GPIO_Label=bin1
PC7.Signal=GPIO_Output
PC8.GPIO_Label=ain2
PC8.Signal=GPIO_Output
PC9.GPIO_Label=ain1
PC9.Signal=GPIO_Output
PD2.GPIO_Label=RES
PD2.Signal=GPIO_Output
PF0-OSC_IN.Signal=RCC_OSC_IN
PF1-OSC_OUT.Signal=RCC_OSC_OUT
PF4.GPIO_Label=sen8
PF4.Signal=ADC1_IN5
