azizelse-0v2/complexio/(commit log)

2026-03-21 Initial schem
    [complexio.kicad_pcb, complexio.kicad_sch]
2026-03-22 Initial code,schem & added assets
    [Sensor_array.kicad_sch, complexio.kicad_pcb, complexio.kicad_sch, ktir0711s-1.stp]
2026-03-22 Generated code using STM32CubeMX
2026-03-23 Sensor array finished & main schem modified
    [AT24C01C-SSHM-B.STEP, SN74LVC16T245DGGR.STEP, Sensor_array.kicad_sch, complexio.kicad_pcb, complexio.kicad_sch, hc-05.stl, oled_spi.stp]
2026-03-24 Changed firmware & SMD of mpu6050+minor changes
    [IMU.kicad_sch, QFN_24.STEP, Sensor_array.kicad_sch, complexio.kicad_pcb, complexio.kicad_sch]
2026-03-25 Advanced with schem & resolved main power problem
    [IMU.kicad_sch, LM2596.kicad_sch, Sensor_array.kicad_sch, complexio.kicad_pcb, complexio.kicad_sch]
